Ineso1/Conversi-n-de-bici-el-ctrica-/BLDC_Controller_interruption_V1/Core/Src/main.c

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
/* Includes ------------------------------------------------------------------*/
#include "main.h"
#include "adc.h"
#include "can.h"
#include "tim.h"
#include "usart.h"
#include "gpio.h"

/* USER CODE BEGIN Includes */
#include <bldc_controller.h>
/* USER CODE END Includes */


void SystemClock_Config(void);
/* USER CODE BEGIN PFP */
struct Bldc bldc;

/* USER CODE END PFP */

/**
  * @brief  The application entry point.
  * @retval int
  */
int main(void)
{
  /* MCU Configuration--------------------------------------------------------*/

  /* Reset of all peripherals, Initializes the Flash interface and the Systick. */
  HAL_Init();

  /* Configure the system clock */
  SystemClock_Config();

  /* Initialize all configured peripherals */
  MX_GPIO_Init();
  MX_USART2_UART_Init();
  MX_ADC4_Init();
  MX_TIM2_Init();
  MX_TIM3_Init();
  MX_TIM4_Init();
  MX_CAN_Init();
  MX_ADC2_Init();
  /* USER CODE BEGIN 2 */
  setPins_Hall(&bldc, HALL_A_GPIO_Port, HALL_A_Pin, HALL_B_GPIO_Port, HALL_B_Pin, HALL_C_GPIO_Port, HALL_C_Pin);
  setPins_Predriver(&bldc, H_A_GPIO_Port, H_A_Pin, H_B_GPIO_Port, H_B_Pin, H_C_GPIO_Port, H_C_Pin, L_A_GPIO_Port, L_A_Pin, L_B_GPIO_Port, L_B_Pin, L_C_GPIO_Port, L_C_Pin);
  setTimers(&bldc, &htim2, &htim3, &htim4);
  setThrottle(&bldc, Throttle_GPIO_Port, Throttle_Pin, &hadc2);
  setISense(&bldc, Current_GPIO_Port, Current_Pin, &hadc4);
  setVSense(&bldc, Voltage_GPIO_Port, Voltage_Pin, &hadc4);
  init(&bldc);

  //char message[] = "Hola, mundo!\r\n";
  //process_halls(&bldc);
  /* USER CODE END 2 */

  /* Infinite loop */
  /* USER CODE BEGIN WHILE */
  while (1)
  {
	//HAL_GPIO_TogglePin(GPIOA, GPIO_PIN_5);
	process_halls(&bldc);
	//HAL_Delay(1);
    /* USER CODE END WHILE */

    /* USER CODE BEGIN 3 */
  }
  return 0;
  /* USER CODE END 3 */
}

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
/* USER CODE BEGIN 4 */
void HAL_ADC_ConvCpltCallback(ADC_HandleTypeDef* hadc) {
	//HAL_GPIO_TogglePin(GPIOA, GPIO_PIN_5);
    if (hadc == bldc.THROTTLE_ADC) {
        adc_irq(&bldc);
    }
}


void HAL_TIM_PWM_PulseFinishedCallback(TIM_HandleTypeDef *htim) {
  if (htim->Instance == TIM2) {
	  	pwm_irq(&bldc);
  }
}

/*
void HAL_TIM_PeriodElapsedCallback(TIM_HandleTypeDef *htim){
	//HAL_GPIO_TogglePin(GPIOA, GPIO_PIN_5);
	//pwm_irq(&bldc);
}
*/


/* USER CODE END 4 */
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
