Ineso1/Conversi-n-de-bici-el-ctrica-/TFT_Controller/Core/Inc/user_setting.h

/*
 * user_setting.h
 *
 *  Created on: 02-Jul-2019
 *      Author: poe
 */

#include "main.h"

#ifndef USER_SETTING_H_
#define USER_SETTING_H_


#define RD_PORT LCD_RD_GPIO_Port
#define RD_PIN  LCD_RD_Pin
#define WR_PORT LCD_WR_GPIO_Port
#define WR_PIN  LCD_WR_Pin
#define CD_PORT LCD_RS_GPIO_Port         // RS PORT
#define CD_PIN  LCD_RS_Pin     			// RS PIN
#define CS_PORT LCD_CS_GPIO_Port
#define CS_PIN  LCD_CS_Pin
#define RESET_PORT LCD_RST_GPIO_Port
#define RESET_PIN  LCD_RST_Pin

#define D0_PORT LCD_D0_GPIO_Port
#define D0_PIN LCD_D0_Pin
#define D1_PORT LCD_D1_GPIO_Port
#define D1_PIN LCD_D1_Pin
#define D2_PORT LCD_D2_GPIO_Port
#define D2_PIN LCD_D2_Pin
#define D3_PORT LCD_D3_GPIO_Port
#define D3_PIN LCD_D3_Pin
#define D4_PORT LCD_D4_GPIO_Port
#define D4_PIN LCD_D4_Pin
#define D5_PORT LCD_D5_GPIO_Port
#define D5_PIN LCD_D5_Pin
#define D6_PORT LCD_D6_GPIO_Port
#define D6_PIN LCD_D6_Pin
#define D7_PORT LCD_D7_GPIO_Port
#define D7_PIN LCD_D7_Pin



#define  WIDTH    ((uint16_t)240)
#define  HEIGHT   ((uint16_t)320)


/****************** delay in microseconds ***********************/
extern TIM_HandleTypeDef htim2;

/*
void delay_c (uint32_t time)
{
	// change your code here for the delay in microseconds
	HAL_Delay(time);
}
*/



// configure macros for the data pins.

/* First of all clear all the LCD_DATA pins i.e. LCD_D0 to LCD_D7
 * We do that by writing the HIGHER bits in BSRR Register
 *
 * For example :- To clear Pins B3, B4 , B8, B9, we have to write GPIOB->BSRR = 0b0000001100011000 <<16
 *
 *
 *
 * To write the data to the respective Pins, we have to write the lower bits of BSRR :-
 *
 * For example say the PIN LCD_D4 is connected to PB7, and LCD_D6 is connected to PB2
 *
 * GPIOB->BSRR = (data & (1<<4)) << 3.  Here first select 4th bit of data (LCD_D4), and than again shift left by 3 (Total 4+3 =7 i.e. PB7)
 *
 * GPIOB->BSRR = (data & (1<<6)) >> 4.  Here first select 6th bit of data (LCD_D6), and than again shift Right by 4 (Total 6-4 =2 i.e. PB2)
 *
 *
 */
  #define write_8(d) { \
   GPIOA->BSRR = 0b1000001100000000 << 16; \
   GPIOB->BSRR = 0b0000010000111000 << 16; \
   GPIOC->BSRR = 0b0000000010000000 << 16; \
   GPIOA->BSRR = (((d) & (1<<0)) >> 9) \
   	   	   	   | (((d) & (1<<2)) >> 8)  \
               | (((d) & (1<<7)) >> 1); \
   GPIOB->BSRR = (((d) & (1<<3)) << 0) \
               | (((d) & (1<<4)) >> 1) \
			   | (((d) & (1<<5)) << 1) \
			   | (((d) & (1<<6)) >> 4); \
   GPIOC->BSRR = (((d) & (1<<1)) >> 6); \
    }


  /* To read the data from the Pins, we have to read the IDR Register
   *
   * Take the same example say LCD_D4 is connected to PB7, and LCD_D6 is connected to PB2
   *
   * To read data we have to do the following
   *
   * GPIOB->IDR & (1<<7) >> 3. First read the PIN (1<<7 means we are reading PB7) than shift it to the position, where it is connected to
   * and in this example, that would be 4 (LCD_D4). (i.e. 7-3=4)
   *
   * GPIOB->IDR & (1<<2) << 4. First read the PIN (1<<2 means we are reading PB2) than shift it to the position, where it is connected to
   * and in this case, that would be 6 (LCD_D6). (i.e. 2+4= 6). Shifting in the same direction
   *
   */
  #define read_8() (          (((GPIOA->IDR & (1<<9)) >> 9) \
                           | ((GPIOC->IDR & (1<<7)) >> 6) \
                           | ((GPIOA->IDR & (1<<10)) >> 8) \
                           | ((GPIOB->IDR & (1<<3)) << 0) \
                           | ((GPIOB->IDR & (1<<5)) >> 1) \
                           | ((GPIOB->IDR & (1<<4)) << 1) \
                           | ((GPIOB->IDR & (1<<10)) >> 4) \
                           | ((GPIOA->IDR & (1<<8)) >> 1)))



/********************* For 180 MHz *****************************/
//#define WRITE_DELAY { WR_ACTIVE8; }
//#define READ_DELAY  { RD_ACTIVE16;}


/************************** For 72 MHZ ****************************/
#define WRITE_DELAY { }
#define READ_DELAY  { RD_ACTIVE;  }


/************************** For 100 MHZ ****************************/
//#define WRITE_DELAY { WR_ACTIVE2; }
//#define READ_DELAY  { RD_ACTIVE4; }


/************************** For 216 MHZ ****************************/
//#define WRITE_DELAY { WR_ACTIVE8; WR_ACTIVE8; } //216MHz
//#define IDLE_DELAY  { WR_IDLE4;WR_IDLE4; }
//#define READ_DELAY  { RD_ACTIVE16;RD_ACTIVE16;RD_ACTIVE16;}


/************************** For 48 MHZ ****************************/
//#define WRITE_DELAY { }
//#define READ_DELAY  { }


/*****************************  DEFINES FOR DIFFERENT TFTs   ****************************************************/

//#define SUPPORT_0139              //S6D0139 +280 bytes
//#define SUPPORT_0154              //S6D0154 +320 bytes
//#define SUPPORT_1289              //SSD1289,SSD1297 (ID=0x9797) +626 bytes, 0.03s
//#define SUPPORT_1580              //R61580 Untested
//#define SUPPORT_1963              //only works with 16BIT bus anyway
//#define SUPPORT_4532              //LGDP4532 +120 bytes.  thanks Leodino
//#define SUPPORT_4535              //LGDP4535 +180 bytes
//#define SUPPORT_68140             //RM68140 +52 bytes defaults to PIXFMT=0x55
//#define SUPPORT_7735
//#define SUPPORT_7781              //ST7781 +172 bytes
//#define SUPPORT_8230              //UC8230 +118 bytes
//#define SUPPORT_8347D             //HX8347-D, HX8347-G, HX8347-I, HX8367-A +520 bytes, 0.27s
//#define SUPPORT_8347A             //HX8347-A +500 bytes, 0.27s
//#define SUPPORT_8352A             //HX8352A +486 bytes, 0.27s
//#define SUPPORT_8352B             //HX8352B
//#define SUPPORT_8357D_GAMMA       //monster 34 byte
//#define SUPPORT_9163              //
//#define SUPPORT_9225              //ILI9225-B, ILI9225-G ID=0x9225, ID=0x9226, ID=0x6813 +380 bytes
#define SUPPORT_9326_5420         //ILI9326, SPFD5420 +246 bytes
//#define SUPPORT_9342              //costs +114 bytes
//#define SUPPORT_9806              //UNTESTED
//#define SUPPORT_9488_555          //costs +230 bytes, 0.03s / 0.19s
//#define SUPPORT_B509_7793         //R61509, ST7793 +244 bytes
//#define OFFSET_9327 32            //costs about 103 bytes, 0.08s




#endif /* USER_SETTING_H_ */
