Ineso1/Conversi-n-de-bici-el-ctrica-/TFT_Controller/Core/Inc/functions.h

/*
 * functions.h
 *
 *  Created on: 29-Jun-2019
 *      Author: poe
 */

#ifndef _FUNCTIONS_H
#define _FUNCTIONS_H

#define	BLACK   0x0000
#define	BLUE    0x001F
#define	RED     0xF800
#define	GREEN   0x07E0
#define CYAN    0x07FF
#define MAGENTA 0xF81F
#define YELLOW  0xFFE0
#define WHITE   0xFFFF


void drawPixel(int16_t x, int16_t y, uint16_t color);
void fillScreen(uint16_t color);
void fillRect(int16_t x, int16_t y, int16_t w, int16_t h, uint16_t color);
void drawLine(int16_t x0, int16_t y0, int16_t x1, int16_t y1, uint16_t color);
void drawRect(int16_t x, int16_t y, int16_t w, int16_t h, uint16_t color);
void drawCircle(int16_t x0, int16_t y0, int16_t r, uint16_t color);
void drawCircleHelper(int16_t x0, int16_t y0, int16_t r, uint8_t cornername, uint16_t color);
void fillCircle(int16_t x0, int16_t y0, int16_t r, uint16_t color);
void fillCircleHelper(int16_t x0, int16_t y0, int16_t r, uint8_t cornername, int16_t delta, uint16_t color);
void drawTriangle(int16_t x0, int16_t y0, int16_t x1, int16_t y1, int16_t x2, int16_t y2, uint16_t color);
void fillTriangle(int16_t x0, int16_t y0, int16_t x1, int16_t y1, int16_t x2, int16_t y2, uint16_t color);
void drawRoundRect(int16_t x0, int16_t y0, int16_t w, int16_t h, int16_t radius, uint16_t color);
void fillRoundRect(int16_t x0, int16_t y0, int16_t w, int16_t h, int16_t radius, uint16_t color);
//void drawBitmap(int16_t x, int16_t y, const uint8_t bitmap[], int16_t w, int16_t h, uint16_t color);
//void drawBitmap(int16_t x, int16_t y, const uint8_t bitmap[], int16_t w, int16_t h, uint16_t color, uint16_t bg);
void drawBitmap(int16_t x, int16_t y, uint8_t *bitmap, int16_t w, int16_t h, uint16_t color);
void drawBitmapbg(int16_t x, int16_t y, uint8_t *bitmap, int16_t w, int16_t h, uint16_t color, uint16_t bg);
//void drawXBitmap(int16_t x, int16_t y, const uint8_t bitmap[], int16_t w, int16_t h, uint16_t color);
//void drawGrayscaleBitmap(int16_t x, int16_t y, const uint8_t bitmap[], int16_t w, int16_t h);
void drawGrayscaleBitmap(int16_t x, int16_t y, uint8_t *bitmap, int16_t w, int16_t h);
//void drawGrayscaleBitmap(int16_t x, int16_t y, const uint8_t bitmap[], const uint8_t mask[], int16_t w, int16_t h);
void drawGrayscaleBitmapmask(int16_t x, int16_t y, uint8_t *bitmap, uint8_t *mask, int16_t w, int16_t h);
//void drawRGBBitmap(int16_t x, int16_t y, const uint16_t bitmap[], int16_t w, int16_t h);
void drawRGBBitmap(int16_t x, int16_t y, uint16_t *bitmap, int16_t w, int16_t h);
//void drawRGBBitmap(int16_t x, int16_t y, const uint16_t bitmap[], const uint8_t mask[], int16_t w, int16_t h);
void drawRGBBitmapmask(int16_t x, int16_t y, uint16_t *bitmap, uint8_t *mask, int16_t w, int16_t h);

void testFastLines(uint16_t color1, uint16_t color2);
void testLines(uint16_t color);
void testFillScreen();
void testRects(uint16_t color);
void testFilledRects(uint16_t color1, uint16_t color2);
void testFilledCircles(uint8_t radius, uint16_t color) ;
void testCircles(uint8_t radius, uint16_t color);
void testFilledRoundRects();
void testRoundRects();
void testFilledTriangles();
void testTriangles();


void scrollup (uint16_t speed);

void scrolldown (uint16_t speed);


#endif /* FUNCTIONS_H_ */
