Ineso1/Conversi-n-de-bici-el-ctrica-/(notices)

Notices in the files:
TFT_Controller/Core/Inc/main.h:
Copyright (c) 2023 STMicroelectronics.
All rights reserved.
This software is licensed under terms that can be found in the LICENSE file
